ltrcao/granular-display/CADs/C-Bot_base/README

Files are taken from C-Bot design on OpenBuilds at http://openbuilds.com/builds/c-bot.1146/

All .stl files need to be printed out by the amount given in parentheses in their filename.
