ltrcao/granular-display/Arduino Motor Driver PSPICE Schematic/Arduino Motor Driver PSPICE Schematic/asdf2.png

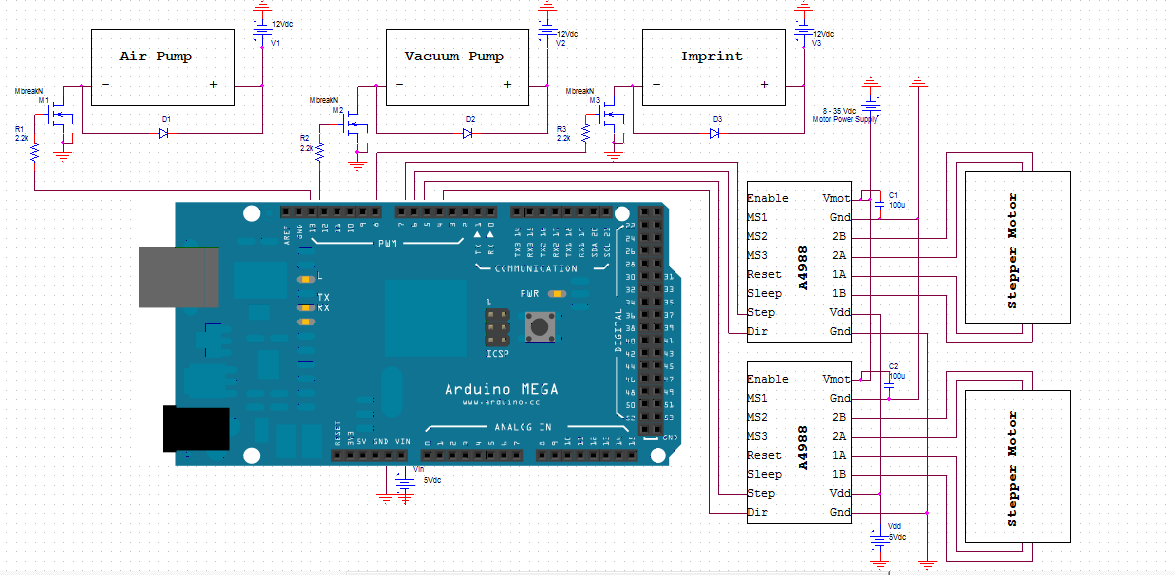
Arduino Motor Driver PSPICE Schematic/Arduino Motor Driver PSPICE Schematic/asdf2.png
