ltrcao/granular-display/Docs/Bill_of_materials.odt

Item (Granular display) | Qty. | Purpose | Reference
Arduino Mega (Atmega2560) | 1 | Microcontroller. 54 I/Os for motor drivers and future expansion. | Link (https://www.sparkfun.com/products/11061)
MOSFETs | 2 | Drivers for pump motor and solenoid valve. Minimum 1A, 12V. | Link (https://www.sparkfun.com/products/10213)
Solenoid valve | 1 | Valve for controlling air tube.
Item (XYZ stage) | Qty. | Purpose | Reference
Stepper drivers | 3 | Drivers for stepper motors on X, Y, Z axes. | Link (https://www.pololu.com/product/1182)
Limit switches | 3 | For homing X, Y, Z axes. | Link (http://www.ebay.com/itm/5-pc-TEMCo-Micro-Limit-Switch-Lever-Arm-Subminiature-SPDT-Snap-Action-LOT-/191202625167)
Stepper motors | 3 | For moving X, Y, Z axes. Use NEMA 17 for ease of design. High torque not necessary.
Timing belts and Pulleys | 2m, 2 | For moving the XY platform. | Link (http://www.ebay.com/itm/2Pcs-GT2-20T-5mm-Bore-6mm-width-Pulley-79-GT2-Timing-Belt-For-3D-Printer-Reprap-/301656602311)
Threaded rod and Coupler | 1, 1 | For moving the pin pressing against the grains. Rod diameter = 8mm is a good starting point.

Additional items:

- Jumper wires, breadboard.
- 5V regulator.
- Diodes, resistors, capacitors.
