ltrcao/granular-display/Docs/BOM_Rework.xls

Sheet: C-Bot BOM
Price Information Accurate Feb. 2016
BOM
Hardware | AMOUNT | Default | COUNT | USD | Alternatives | COUNT | USD | COMMENT
20x40 Extrusion, 1m | 9 | OpenBuilds, Silver (http://openbuildspartstore.com/v-slot-linear-rail/) | 9 | $18.14 | OpenBuilds, Black (http://openbuildspartstore.com/v-slot-linear-rail/) | 9 | $19.96 | Exact amount depends on the heated bed dimension you get
V-Slot Mini V Wheel | 4x5 | OpenBuilds, Derlin (http://openbuildspartstore.com/delrin-mini-v-wheel/) | 20 | $1.25 | OpenBuilds, Extreme (http://openbuildspartstore.com/xtreme-mini-v-wheel/) | 20 | $3.58
V-Wheel Bearings | 40 | Ebay, MR105ZZ (http://www.ebay.com/itm/10pcs-MR105-MR105ZZ-Miniature-Bearings-Ball-Mini-Bearing-5-X-10-X-4mm-/390391020251) | 4 | $3.28 | Ebay, MR105-2RS (http://www.ebay.ca/itm/10pcs-MR105-2RS-Rubber-Sealed-Ball-Bearing-Miniature-Bearing-5-x-10-x-4mm-Blue-/331662658625) | 4 | $4.00 | you can get the rubber seals in cool colors
Precision shim | 20 | OpenBuilds (http://openbuildspartstore.com/mini-v-wheel-precision-shim/) | 20 | $0.28 |  |  |  | Needed between each pair of V-wheel bearings
Short Spacers | 32 | 3D Print (http://www.openbuilds.com/builds/c-bot.1146/) | 0 | $0.00 | Spacer, 6mm (http://openbuildspartstore.com/aluminum-spacers/) | 40 | $0.28
Long Spacers | 8 | 3D Print (http://www.openbuilds.com/builds/c-bot.1146/) | 0 | $0.00 | Spacer, 20mm (http://openbuildspartstore.com/aluminum-spacers/) | 8 | $0.63
 |  |  |  |  | Extra shims to use above two (http://openbuildspartstore.com/mini-v-wheel-precision-shim/) | 40 | $0.28
8mm lead Screw | 30-50cm x2 | Ebay, combo (http://www.ebay.ca/itm/500mm-Length-Lead-Screw-8mm-Screw-Pitch-Brass-Nut-for-Reprap-3D-Printer-Z-Axis-/261941269628) | 2 | $12.00 | MTW, two start (http://store.makerstoolworks.com/motion/two-start-lead-screw-and-nut-single/) | 2 | $24.95 | 4 Start is typical, but 2 start would be better if you can source it in the length needed
5mm/8mm Flex Coupling | 2 | Ebay, Spiral Type (http://www.ebay.ca/itm/5x8-mm-Motor-Jaw-Shaft-Coupler-5mm-To-8mm-Flexible-Coupling-OD-19x25mm-SU-/221594917783) | 2 | $1.10 | Ebay, Jaw Clamp Type (http://www.ebay.ca/itm/400525695992?_trksid=p2060353.m1438.l2649&ssPageName=STRK%3AMEBIDX%3AIT) | 2 | $8.59 | 3D print (http://www.thingiverse.com/thing:366040)
GT2 16 Tooth Pulley | 2 | Ebay (http://www.ebay.ca/itm/2pcs-GT2-Aluminum-Timing-Pulleys-RepRap-Prusa-Mendel-3D-Printer-16-Tooth-Teeth-/141522888429) | 1 | $5.99 | Amazon, combo (http://www.amazon.com/Anycubic-Timing-Pulleys-Meters-Printer/dp/B0152ZNDLK) | 1 | $14.98
GT2 Belt | 2-5m | Ebay (http://www.ebay.ca/itm/5-Meter-197-6mm-Width-GT2-Timing-Belt-For-3D-printer-Rostock-Mendel-REPRAP-/252232179286) | 1 | $6.20
MK8 drive pulley | 1-2 | Ebay (http://www.ebay.ca/itm/Feedstock-Wheel-Extruder-Gear-Hobbed-Gear-Drive-Gear-for-Reprap-3D-printer-good-/121349742050) | 1 | $2.00 | Ebay, alternate (http://www.ebay.com/itm/1-75-3mm-3D-Printer-MK8-Drive-Gear-for-RepRap-Makerbot-Filament-Extruder-Pulley-/252055736275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)
F623ZZ Flange Bearing | 16 | Ebay (http://www.ebay.com/itm/10-x-F623zz-Mini-Metal-Double-Shielded-Flanged-Ball-Bearings-/231540202636) | 2 | $4.99 | Ebay, alternate (http://www.ebay.ca/itm/10pcs-Mini-F623ZZ-3x10x4mm-Double-Shielded-Flange-Ball-Bearing-Flanged-Bearing-/252169403902) | 2 | $5.60
625ZZ Bearing (for extruder) | 1-2 | Ebay (http://www.ebay.ca/itm/2pcs-625ZZ-Miniature-Bearings-ball-Mini-Bearing-5mm-16mm-5mm-/141204979309) | 1 | $1.99 | Ebay, alternate (http://www.ebay.ca/itm/2pcs-625ZZ-Miniature-Bearings-ball-Mini-Bearing-5mm-16mm-5mm-/141204979309) | 1 | $1.98
1/8" Push In Fitting | 2-4 | Ebay (http://www.ebay.ca/itm/5pcs-1-8-Push-In-Fittings-F-bowden-extruder-1-75mm-4mm-OD-PTFE-Tube-3D-Printer-/331723162262) | 1 | $4.00
Bulldog clips | 8 | Ebay (http://www.ebay.ca/itm/10x-Mini-19mm-Metal-Fold-Back-Letter-Notes-Receipt-Money-File-Paper-Binder-Clips-/351587197720) | 1 | $1.50 | Amazon (http://www.amazon.com/Officemate-Silver-Binder-Assorted-31021/dp/B00006IBA2?s=office-products) | 1 | $2.89
Bed Leveling Springs | 4 | Ebay (http://www.ebay.ca/itm/NEW-4pcs-Heated-Bed-Spring-8mm-3D-Printer-DIY-Accessories-/331324945571) | 1 | $4.00 | homedepot (http://www.homedepot.com/p/Everbilt-Spring-Assortment-Kit-84-Pack-15642/202045461) | 1 | $4.37
Extuder Spring | 1-2 | Hobby Shop? | 1 | $1.00 | Ebay, 7mm OD 25mm L (http://www.ebay.ca/itm/0-6mm-Wire-Diameter-5-50mm-L-304-Stainless-Steel-Pressure-Compression-Spring-/281912361412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) | 1 | 9.99 | Mine was from a random spring kit
Heated Bed, various sizes | 1 | Maker Farm (http://www.makerfarm.com/index.php/heat-beds/12-x-12-heat-bed.html) | 1 | $46.50 | Ebay (http://www.ebay.com/itm/RepRap-PCB-Heatbed-200x300mm-Dual-power-12-24V-Perfect-for-Prusa-i3-etc-/281311483823) | 1 | $19.20
Heated Bed Insulation | 1 | Cardboard | 1 | $0.00 | Amazon (http://www.amazon.com/gp/product/B0018DHBAK?psc=1&redirect=true&ref_=oh_aui_detailpage_o01_s00) | 1 | $10.40
Glass to match heated bed | 1 | Household Store/IKEA | 1 | $10.00 | Voxel Factory (https://www.voxelfactory.com/collections/hardware/products/custom-cut-borosilicate-glass) | 1 | $42.37 | Picture frame sales are a good source of cheap glass, boresilicate is best though
Cable/Zip Tie, 4+ | 4-8 | Ebay (http://www.ebay.ca/itm/New-100pcs-Black-8-3x200mm-Locking-Nylon-Plastic-Cable-Wire-Zip-Ties-Cord-Wrap-/291198607167) | 1 | $2.68 |  |  |  | to hold tube and wires to XY carriage
Electrical
Nema 17 Motor | 5-6 | ATinc, Nema 17 (http://www.automationtechnologiesinc.com/products-page/3d-printer/nema17-stepper-motor-kl17h247-150-4a-for-3d-printer) | 5 | $8.99 | Ebay (http://www.ebay.ca/itm/1pcs-3D-Printers-Reprap-68g-cm2-Lead-1-8-Degree-12V-1-2A-Nema17-Stepper-Motor-/291595158449) | 5 | $18.33 | get 68oz*in or better
12V/30A Power Supply | 1 | Amazon (http://www.amazon.com/gp/product/B00D7CWSCG?psc=1&redirect=true&ref_=oh_aui_detailpage_o03_s00) | 1 | $23.97 | Ebay (http://www.ebay.ca/itm/Hot-12V-30A-AC-DC-PSU-Regulated-Switching-Power-Supply-350W-Brand-New-/262242869774) | 1 | $33.95 | Or repurpose an old PC power supply
Print Control Board | 1 | Ramps 1.4 Kit, Ebay (http://www.ebay.ca/itm/3D-Printer-Kit-RAMPS-1-4-Mega2560-A4988-12864-LCD-Controller-for-Arduino-Reprap-/252181241032) | 1 | $31.99 | Azteeg X3 (http://www.panucatt.com/Azteeg_X3_reprap_3d_printer_controller_p/ax33dp.htm) | 1 | $109.99 | Ramps comes bundled in many types of packages
Stepper Drivers | 5 | DRV8825, Ebay (http://www.ebay.ca/itm/Geeetech-Stepper-driver-Pololu-DRV8825-StepStick-for-RAMPS-Sanguinololu-Teensylu-/331167037633) | 5 | $1.59 |  |  |  | DRV8825 can handle more amps and higher temps than A4998s
Endstop for Y and Z | 2 | Ebay (http://www.ebay.com/itm/3x-Mechanical-End-Stop-Endstop-Switch-Module-V1-2-3D-printer-Reprap-Mendel-Pursa-/271443703227) | 1 | $4.49
Endstop connectors | 2 | Ebay (http://www.ebay.com/itm/20PCS-4-pins-white-Connector-leads-Head-XH2-54-2-54mm-connector-kit-DIP-4p-/330928070002) | 2 | $1.62
Endstop for XY carraige | 1 | Ebay (http://www.ebay.ca/itm/Toggle-Collision-Limit-switch-Travel-Switch-for-Robot-Arduino-Brand-New/351214665011) | 1 | $1.77
HotEnd | 1-2 | Filastuder, E3D Lite (http://www.filastruder.com/products/lite6) | 1 | $39.99 | Filastuder, E3Dv6 (http://www.filastruder.com/products/all-metal-e3d-v6-hotend) | 1 | $79.99
Heated Bed Thermister | 1 | Ebay (http://www.ebay.com/itm/100Kohm-NTC-thermistor-temperture-sensor-for-Reprap-hotbed-PCB-MK2a-heated-bed-/231204000452) | 1 | $0.99
Power Switch/ receptacle | 1 | Ebay (http://www.ebay.ca/itm/Panel-IEC320-C14-Inlet-Power-Socket-On-Off-SPST-Red-Rocker-Switch-AC-250V-10A-/321513901251) | 1 | $3.94 | Amazon (http://www.amazon.com/gp/product/B00511QVVK?psc=1&redirect=true&ref_=od_aui_detailpages00) | 1 | $4.44
Relay | 1 | Ebay, Mech (http://www.ebay.ca/itm/30A-High-Current-Contactor-Switch-12V-Electric-Relay-Board-DC-Power-Control-new-/221977262205) | 1 | $4.26 | Amazon, SSR (http://www.amazon.com/Single-Phase-SSR-40DD-DC3-32V-DC5-60V/dp/B012SW6TB6?s=hi) | 1 | $11.71
Cooling Fan, 40mm | 1-3 | Amazon (http://www.amazon.com/gp/product/B00E1JO8SG?psc=1&redirect=true&ref_=oh_aui_detailpage_o00_s00) | 2 | $2.04 | Ebay (http://www.ebay.ca/itm/1pcs-40mm-x-15mm-12V-2Pin-40-40-15MM-Mini-DC-Cooling-Fan-Brushless-Heatsink-/271700616463) | 2 | $2.99 | look at CFM rating
Wire Wrap | 1m | Ebay (http://www.ebay.ca/itm/10-Feet-3-8-Split-Loom-Wire-Flexible-Tubing-Conduit-Polyethylene-Hose-Sales-/261702819864) | 1 | $3.05
4 Core Project Wire | 10m | Ebay (http://www.ebay.ca/itm/2-6-Multicore-Cable-Flexible-Points-Signal-Small-Power-Data-AUTO-Core-CAR-Wire-/261323374911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) | 1 | $13.99
Dupont Connector Cover, 4 pin | 6 | Ebay (http://www.ebay.ca/itm/100pcs-2-54mm-4P-Pitch-Dupont-Jumper-Wire-Cable-Housing-Female-Pin-Connector-/281215490269) | 1 | $1.59
Dupont Connector Cover, 3 pin | 3 | Ebay (http://www.ebay.ca/itm/100pcs-2-54mm-3P-Pitch-Dupont-Jumper-Wire-Cable-Housing-Female-Pin-Connector-/281215488189) | 1 | $1.29
Dupont Connector Cover, 2 pin | 2-3 | Ebay (http://www.ebay.ca/itm/100pcs-2-54mm-2P-Pitch-Dupont-Jumper-Wire-Cable-Housing-Female-Pin-Connector-/281215486233) | 1 | $1.08
Dupont Female Pins | 37 | Ebay (http://www.ebay.ca/itm/500Pcs-Dupont-Jumper-Wire-Cable-Housing-Female-Pin-Connector-Terminal-2-54mm-L-/252045479834) | 1 | $2.55
Fastners
M3 Socket Bolt, 10mm | 50 | mrmetric (http://www.mrmetric.com/metric-fasteners/metric-socket-screw-steel-alloy-12-9/M10045.html) | 50 | $0.10 |  |  |  | for motor mounts, belt clamps, tube holders, endstop attachment
M3 Socket Bolt, 14mm | 2 | mrmetric (http://www.mrmetric.com/metric-fasteners/metric-socket-screw-steel-alloy-12-9/M10047.html) | 2 | $0.11 |  |  |  | for extruder tension arm pivot
M3 Socket Bolt, 20mm | 17-21 | mrmetric (http://www.mrmetric.com/metric-fasteners/metric-socket-screw-steel-alloy-12-9/M10053.html) | 17 | $0.11 |  |  |  | for leadscrew nut blocks, LCD frame, heated bed
M3 Socket Bolt, 25mm | 12 | mrmetric (http://www.mrmetric.com/metric-fasteners/metric-socket-screw-steel-alloy-12-9/M10054.html) | 12 | $0.18 |  |  |  | for belt idlers and hotend clamps
M3 Nut | 30 | mrmetric (http://www.mrmetric.com/metric-fasteners/sc8z-metric-hex-nut/M50013.html) | 30 | $0.02
M3 Nyloc Nut | 17 | mrmetric (http://www.mrmetric.com/metric-fasteners/sc8z-metric-nylock-nuts/M50303.html) | 17 | $0.02
M3 Washer | 80 | mrmetric (http://www.mrmetric.com/metric-fasteners/metric-flat-washer-steel-zinc/M60010.html) | 80 | $0.01 |  |  |  | for bolts and for spacing flanged bearing to make idlers
M5 Socket Bolt, 10mm | 220 | mrmetric (http://www.mrmetric.com/metric-fasteners/metric-socket-screw-steel-alloy-12-9/M10089.html) | 220 | $0.05 |  |  |  | bracket to extrusion connections (lots!)
M5 Socket Bolt, 12mm | 2 | mrmetric (http://www.mrmetric.com/metric-fasteners/metric-socket-screw-steel-alloy-12-9/M10091.html) | 2 | $0.17 |  |  |  | Y endstop bracket
M5 Socket Bolt, 14mm | 2 | mrmetric (http://www.mrmetric.com/metric-fasteners/metric-socket-screw-steel-alloy-12-9/M10093.html) | 2 | $0.16 |  |  |  | Z endstop bracket
M5 Socket Bolt, 40mm | 13 | mrmetric (http://www.mrmetric.com/metric-fasteners/metric-socket-screw-steel-alloy-12-9/M10106.html) | 13 | $0.18 |  |  |  | XY Slides and XY Carriage + Z axis fine adjustment
M5 Socket Bolt, 60mm | 8 | mrmetric (http://www.mrmetric.com/metric-fasteners/metric-socket-screw-steel-alloy-12-9/M10323.html) | 8 | $0.40 |  |  |  | Z Slides
M5 Nyloc Nut | 20 | mrmetric (http://www.mrmetric.com/Discount-Items/Discount-Metric-Nuts/M50306.html) | 20 | $0.07 |  |  |  | V wheel assemblies
M5 Washer | 250 | mrmetric (http://www.mrmetric.com/metric-fasteners/metric-flat-washer-steel-zinc/M60019.html) | 250 | $0.01 |  |  |  | V wheel assemblies, frame construction
M5 Tee Nuts | 225 | OpenBuilds, T-Nuts (http://openbuildspartstore.com/tee-nuts-25-pack/) | 9 | $6.89 | mrmetric, Square Nuts (http://www.mrmetric.com/metric-fasteners/sc4z-metric-square-nuts/M53065.html) | 225 | $0.04 | Don't cheap out and print nuts (my advice from experience)
 |  |  |  | 618.25 | USD
Optional
Dupont Connector Crimp Pliers | 1 | Ebay (http://www.ebay.ca/itm/Pin-Crimping-Tool-Crimper-2-54mm-3-96mm-KF2510-28-18-AWG-Plier-0-1-1-0m-YUCA-/291275778695) | 1 | 12
M3 Thumb Nuts, for bed leveling | 5 | mrmetric (http://www.mrmetric.com/metric-fasteners/sc8z-metric-knurled-nuts/M50759.html) | 5 | $1.32
M5 Thumb Nut, for extruder idler spring | 2 | mrmetric (http://www.mrmetric.com/metric-fasteners/sc8z-metric-knurled-nuts/M50782.html) | 2 | $1.17
Extra Strength Hair Spray | 1 | Local Drug Store | 1 | $8.00
8mm threaded rod for roll holder | 1 | Local Hardware | 1 | $8.00
+ 8mm nut | 2-4 | mrmetric (http://www.mrmetric.com/metric-fasteners/sc10z-metric-hex-nut-m8/) | 2 | $0.12
+ 608ZZ Bearings | 2-4 | Ebay (http://www.ebay.ca/itm/10-x-608ZZ-Deep-Groove-Ball-Bearings-8-22-7mm-for-3D-Printer-8mm-Bore-/261953133583) | 1 | $3.99
M5 Washer 15mm OD | 2 | mrmetric (http://www.mrmetric.com/metric-fasteners/metric-flat-large-od-washer-steel-z/M60355.html) | 2 | $0.03 |  |  |  | Larger Washer for Extruder Spring
M5 Low Profile Bolt, 10mm | 16 | mrmetric (http://www.mrmetric.com/metric-fasteners/metric-button-socket-screws-steel-10-9/M11410.html) | 16 | $0.10 |  |  |  | Optional: for inside of lower frame corner brackets
LEDS | 1 | Amazon (http://www.amazon.com/gp/product/B006LW2NJM?psc=1&redirect=true&ref_=od_aui_detailpages00) | 1 | $8.69 | Ebay (http://www.ebay.ca/itm/10M-600LEDS-3528-SMD-RGB-2X-5M-LED-light-strip-44-Key-IR-Remote-Controller-LU-/161811338109) | 1 | $9.00
Thermal Paste | 1 | Amazon (http://www.amazon.com/gp/product/B00KAOP4SY?psc=1&redirect=true&ref_=oh_aui_detailpage_o02_s00) | 1 | $4.99
 |  |  |  | 56.51 | USD

Sheet: Extrusions Lengths
Heated Bed Dimensions:
If your bed is not square, put the longer side as the length (L)
 | L | W
Enter--> | 320 | 320 | mm
***bed mount hole to mount hole
Lead Screw Length:
 | L
 | 300 | mm
Cut Aluminum lengths to:
Count | Length |  | Purpose
X4 | 480 | mm | <-- front/back, top/bottom horizontal stationary pieces
X1 | 466 | mm | <-- the back/Z moving piece
X1 | 506 | mm | <-- the top/XY moving piece
X2 | 480 | mm | <-- top sides
X2 | 460 | mm | <-- bottom sides
X4 | 450 | mm | <-- legs, gives some flexibility for hotend length and mounting
X2 | 445 | mm | <-- bed support
x1 | 240 | mm | <-- bed front cross piece, only necessary for the front/back leadscrew option
x1 | 520 | mm | <-- offset motor mount option, only necessary for offset Z axis option (AKA D-Bot)
 | 7.462 | m | <--original rear motor mount option
 | 7.702 | m | <--front back leadscrew option
 | 7.982 | m | <--offset leadscrew option
