ltrcao/granular-display/Docs/Extrusion_BOM.xls

Hardware | Amount | Reference | Cost | Purpose | Comment
V-Slot 20x40 Extrusion, 250mm | 5 | OpenBuilds (http://openbuildspartstore.com/v-slot-linear-rail/) | $18.75 | Parts of the frame
V-Slot 20x20 Extrusion, 250mm | 1 | OpenBuilds (http://openbuildspartstore.com/v-slot-linear-rail/) | $3.00 | Part of the frame
V-Slot Mini V-Wheel | 12 | OpenBuilds (http://openbuildspartstore.com/delrin-mini-v-wheel-kit/) | $47.40 | Linear guide for moving along axes | 12 = 4 for y-axis left slider + 4 for y-axis right slider + 4 for x-axis slider
F623ZZ Flange Bearing | 16 |  |  | Guide for timing belt
 |  |  | $69.15
Fasteners
M3 socket bolt, 10mm | 50 | mr. metric (http://www.mrmetric.com/M10045) | $3.50 | For motor mounts, belt clamps, etc. | Amounts listed for fasteners may be more than necessary, but extras are always handy.
M3 socket bolt, 25mm | 12 | mr. metric (http://www.mrmetric.com/M10054) | $2.16 | For belt idlers
M3 nut | 30 | mr. metric (http://www.mrmetric.com/M50013) | $0.60 | Nuts to go with majority of bolts
M3 locknut | 17 | mr. metric (http://www.mrmetric.com/M50303) | $0.34
M3 washer | 80 | mr. metric (http://www.mrmetric.com/M60010) | $2.40 | For use with bolts
M5 socket bolt, 10mm | 220 | mr. metric (http://www.mrmetric.com/M10089) | $17.60 | For connecting brackets to aluminum extrusion
M5 socket bolt, 12mm | 2 | mr. metric (http://www.mrmetric.com/M10091) | $0.34 | For connecting Y-endstop bracket
M5 socket bolt, 40mm | 13 | mr. metric (http://www.mrmetric.com/M10106) | $2.60 | For XY sliders and carriage
M5 locknut | 20 | mr. metric (http://www.mrmetric.com/M50306) | $1.40 | For V-Wheel assembly
M5 washer | 250 | mr. metric (http://www.mrmetric.com/M60019) | $2.50 | For use with bolts
M5 square nut | 225 | mr. metric (http://www.mrmetric.com/M53065) | $9.00 | For connecting brackets to aluminum extrusion
 |  |  | $42.44
 |  |  | $111.59
