ltrcao/granular-display/CADs/C-Bot_base/C-BOT XY Slide Idler (x1).stl

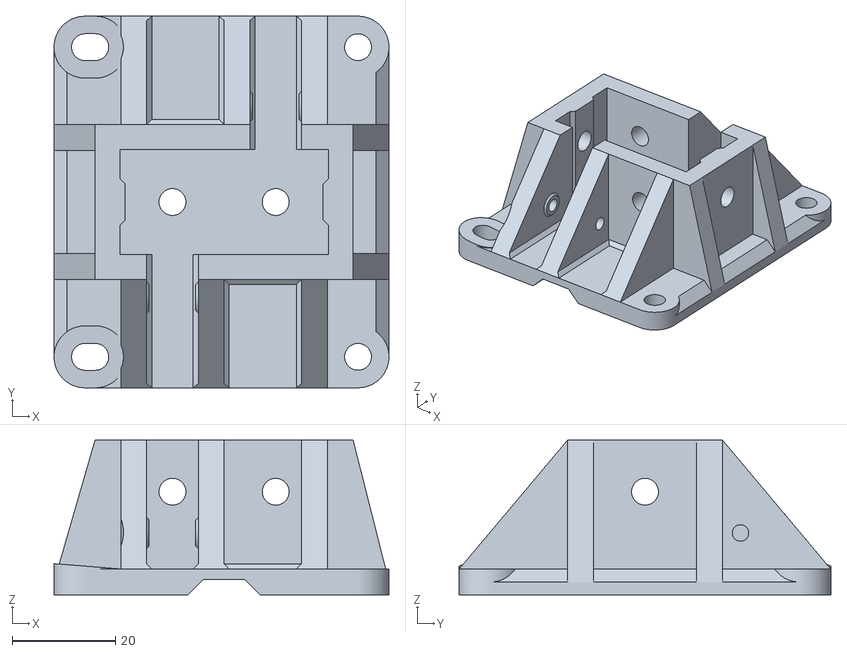
[picture p10: CAD file, 2017-02-10]
CADs/C-Bot_base/C-BOT XY Slide Idler (x1).stl
64.9 x 72.0 x 30.0
