ltrcao/granular-display/CADs/C-Bot_carriage/C-Bot Belt Clamp set of 4.stl

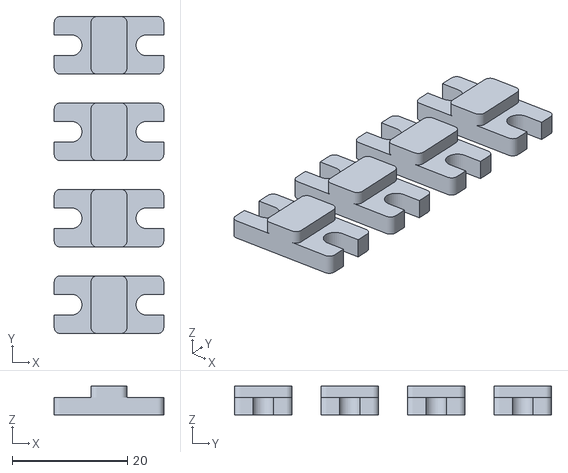
[picture p11: CAD file, 2017-03-13]
CADs/C-Bot_carriage/C-Bot Belt Clamp set of 4.stl
19.0 x 55.0 x 5.00
