ltrcao/granular-display/CADs/C-Bot_carriage/template/C-Bot Bowden Single Front Plate (x1).stl

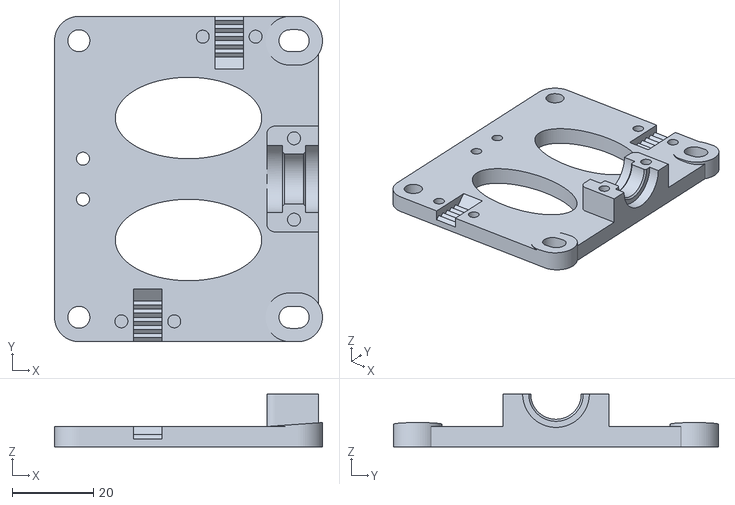
[picture p12: CAD file, 2017-02-10]
CADs/C-Bot_carriage/template/C-Bot Bowden Single Front Plate (x1).stl
65.9 x 80.0 x 13.0
