ltrcao/granular-display/CADs/workarounds/v-slot_filler_19h.stl

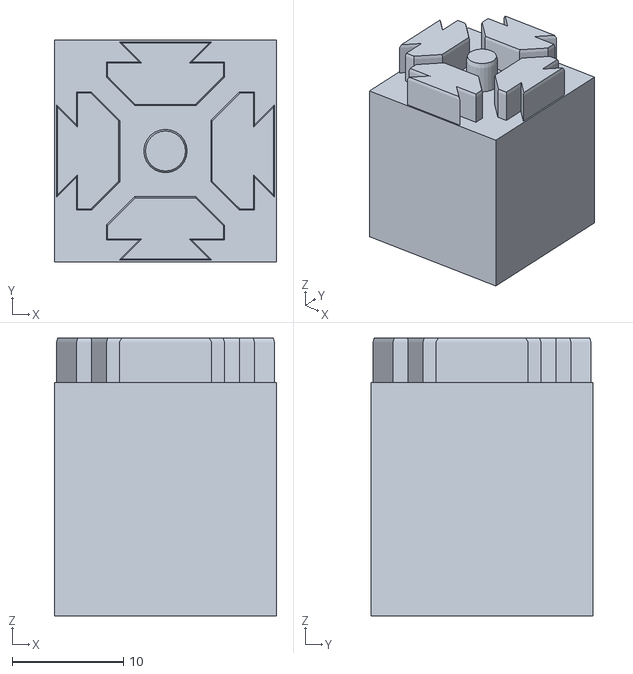
[picture p13: CAD file, 2017-03-13]
CADs/workarounds/v-slot_filler_19h.stl
20.0 x 20.0 x 25.0
