ltrcao/granular-display/CADs/C-Bot_carriage/C-Bot Belt Clamp (x4).stl

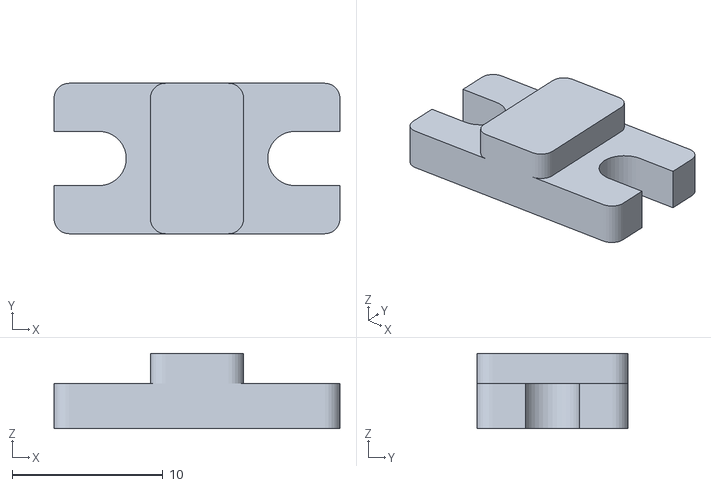
[picture p14: CAD file, 2017-02-10]
CADs/C-Bot_carriage/C-Bot Belt Clamp (x4).stl
19.0 x 10.0 x 5.00
