ltrcao/granular-display/CADs/C-Bot_carriage/template/C-Bot Bowden Carriage Rear Plate (x1).stl

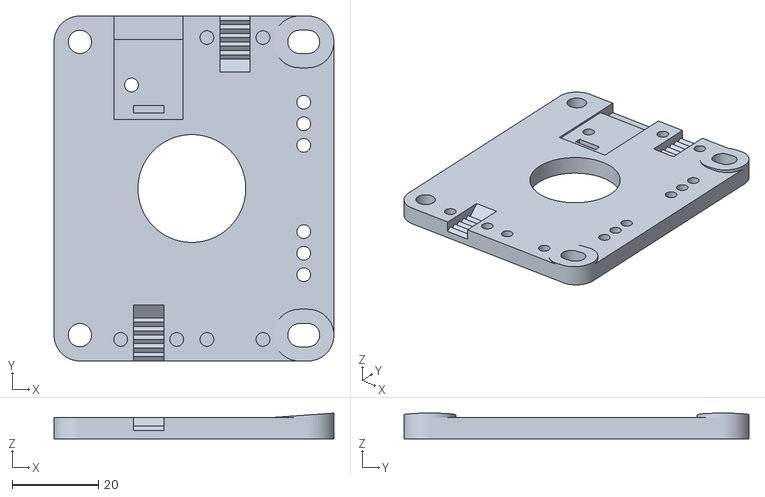
[picture p15: CAD file, 2017-02-10]
CADs/C-Bot_carriage/template/C-Bot Bowden Carriage Rear Plate (x1).stl
64.9 x 80.0 x 6.00
