ltrcao/granular-display/CADs/workarounds/v-slot_filler_39h.stl

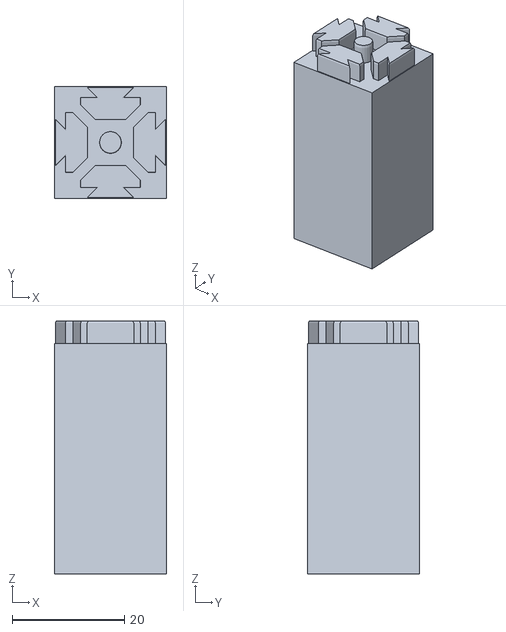
[picture p16: CAD file, 2017-03-13]
CADs/workarounds/v-slot_filler_39h.stl
20.0 x 20.0 x 45.0
