ltrcao/granular-display/CADs/C-Bot_base/C-BOT V-Wheel Spacer (x16).stl

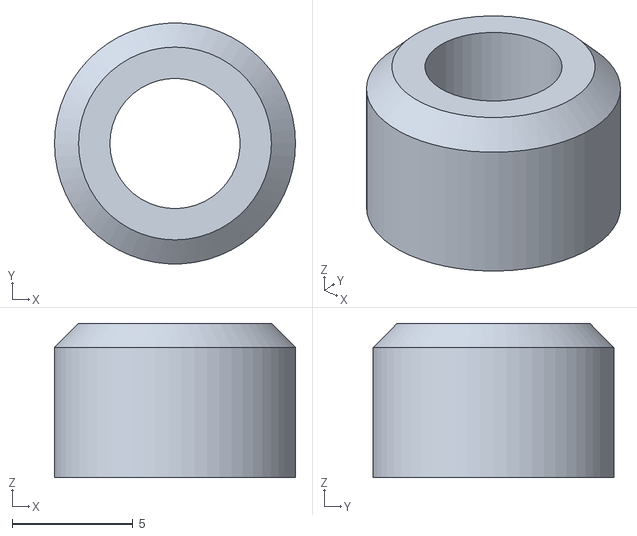
[picture p17: CAD file, 2017-02-10]
CADs/C-Bot_base/C-BOT V-Wheel Spacer (x16).stl
10.0 x 9.99 x 6.40
