ltrcao/granular-display/CADs/workarounds/v-slot_filler_20h.stl

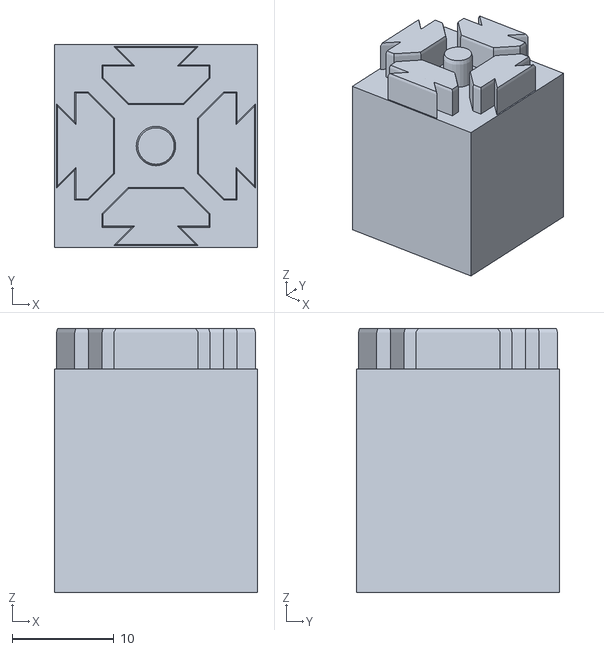
[picture p18: CAD file, 2017-03-13]
CADs/workarounds/v-slot_filler_20h.stl
20.0 x 20.0 x 26.0
