ltrcao/granular-display/CADs/C-Bot_base/C-BOT XY Rear Idler (x1).stl

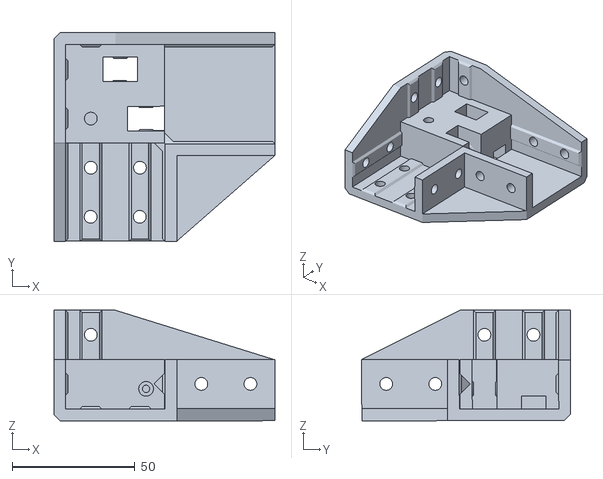
[picture p19: CAD file, 2017-02-10]
CADs/C-Bot_base/C-BOT XY Rear Idler (x1).stl
90.0 x 85.0 x 45.0
