ltrcao/granular-display/CADs/workarounds/v-slot_endcap_2020_fixed.stl

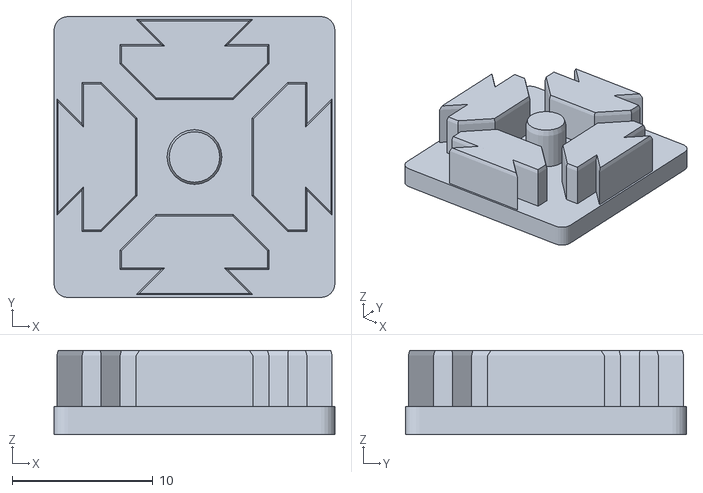
[picture p20: CAD file, 2017-02-09]
CADs/workarounds/v-slot_endcap_2020_fixed.stl
20.0 x 20.0 x 6.00
