ltrcao/granular-display/CADs/workarounds/v-slot_endcap_2020.stl

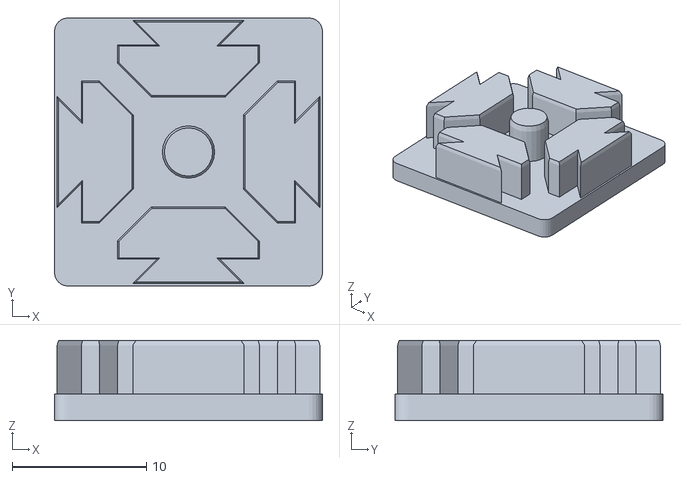
[picture p21: CAD file, 2017-02-09]
CADs/workarounds/v-slot_endcap_2020.stl
20.0 x 20.0 x 6.00
