ltrcao/granular-display/CADs/C-Bot_base/C-BOT XY Motor Mount Right (x1).stl

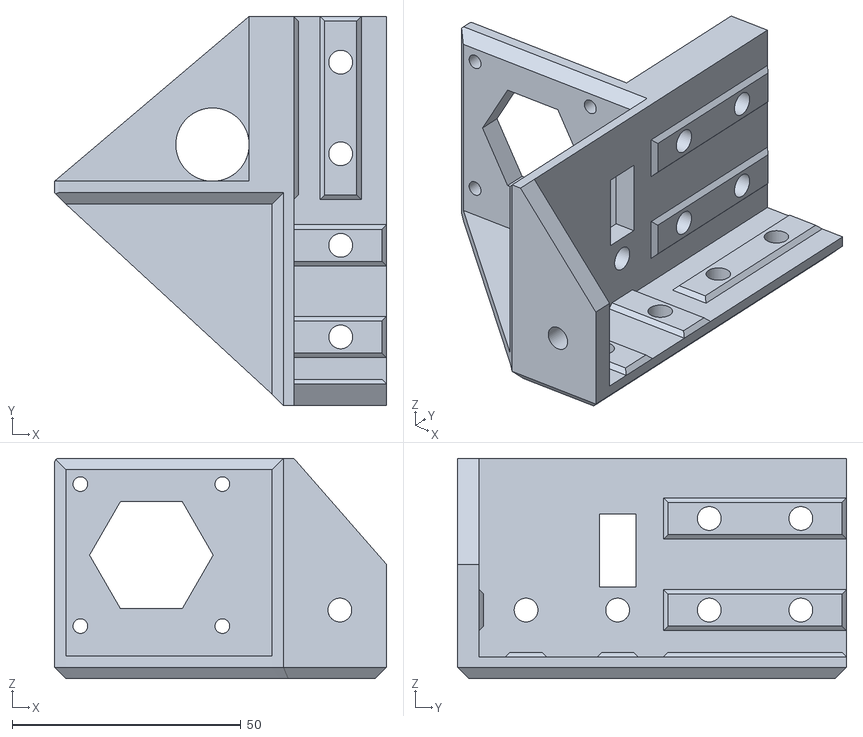
[picture p22: CAD file, 2017-02-10]
CADs/C-Bot_base/C-BOT XY Motor Mount Right (x1).stl
72.5 x 85.0 x 48.2
