ltrcao/granular-display/CADs/C-Bot_base/C-BOT XY Slide Rear Plate (x2).stl

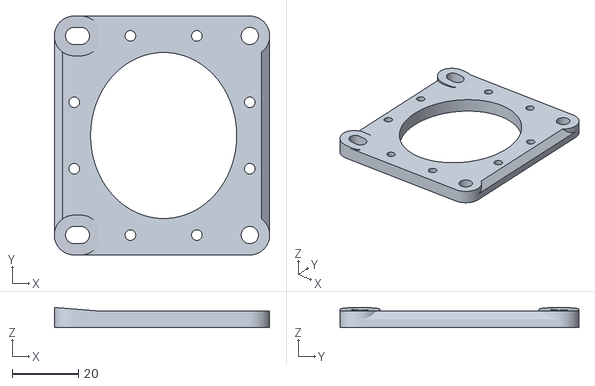
[picture p23: CAD file, 2017-02-10]
CADs/C-Bot_base/C-BOT XY Slide Rear Plate (x2).stl
64.9 x 72.0 x 6.06
