ltrcao/granular-display/CADs/scrapped_designs/XY_Stage/config.scad

// ===========================================================================
// Configuration file for the whole XY-stage design.
// ===========================================================================

// Parameters for stepper bracket
BRACKET_EDGE_LENGTH = 42.3;
BRACKET_DIAMETER = 22;
BRACKET_THICKNESS = 4;
SCREW_DIAMETER = 3;
SCREW_DISTANCE = 31;
SHAFT_HEIGHT = 24;
// ------------------------------

// Parameters for anchor
ANCHOR_THICKNESS = 4;
ANCHOR_SHAFT_OVERHEAD = 4;
ANCHOR_WIDTH = 40;
ANCHOR_SCREW_MARGIN = 7;
ANCHOR_SCREW_DIAMETER = 3;
// ---------------------

// Parameters for pulleys
PULLEY_INNER_DIAMETER = 8;
PULLEY_OUTER_DIAMETER = 25;
PULLEY_WIDTH = 9;
PULLEY_MARGIN = 3;
PULLEY_BACK_THICKNESS = 5;
PULLEY_DISTANCE = 3;
// ---------------------

PULLEY_CENTER = (PULLEY_MARGIN + PULLEY_OUTER_DIAMETER) / 2;
PULLEY_HEIGHT = 2 * PULLEY_WIDTH + 2 * ANCHOR_THICKNESS + PULLEY_DISTANCE;
PULLEY_EDGE_LENGTH = PULLEY_OUTER_DIAMETER + PULLEY_MARGIN;

// Parameters for stage brackets
ROD_BRACKET_DIAMETER = 8;
ROD_BRACKET_DEPTH = 5;
ROD_BRACKET_THICKNESS = 4;
// -----------------------------

ROD_BRACKET_WIDTH = (PULLEY_OUTER_DIAMETER - PULLEY_INNER_DIAMETER) / 2;
ROD_BRACKET_LENGTH = ROD_BRACKET_DIAMETER + ROD_BRACKET_THICKNESS;

// Parameters for the platform
PLATFORM_LENGTH = 40;
PLATFORM_WIDTH = 60;
LINEAR_BEARING_OUTER_DIAMETER = 15;
LINEAR_BEARING_BRACKET_THICKNESS = 2;
TIMING_BELT_PITCH = 2;
TIMING_BELT_CREST = 1.5; // default: 1.38
TIMING_BELT_TROUGH = 0.75; // default: 0.75
TIMING_BELT_TRAP_THICKNESS = 4;
// ---------------------------

TIMING_BELT_TRAP_WIDTH = 5.5 * TIMING_BELT_PITCH;
LINEAR_BEARING_BRACKET_WIDTH = LINEAR_BEARING_BRACKET_THICKNESS * 2 + LINEAR_BEARING_OUTER_DIAMETER;


// Parameters for XY-stage
STEPPER_MOTOR_PULLEY_DIAMETER = 20;
STEPPER_MOTOR_PULLEY_HEIGHT = 12;
// ----------------------
