ltrcao/granular-display/CADs/supportive_grid.scad

//%translate([0,0,-8.8]) import("supportive_grid_parab.stl");

// The design is parametric, so only the constants below need to be changed.
//// Dimension configuration ////
//$fn = 40; // Set $fn to 40 before exporting to .stl to round the pinheads.
NUM_GRID_X = 16;
NUM_GRID_Y = 16;
GRID_LENGTH_X = 10;
GRID_LENGTH_Y = 10;
THREAD_WIDTH_X = 2;
THREAD_WIDTH_Y = 2;
THREAD_THICKNESS_X = 2.5;
THREAD_THICKNESS_Y = 2.5;
WALL_THICKNESS = 10;
WALL_HEIGHT = 5;

PIN_THICKNESS = 4;
PIN_LENGTH = 8;
PIN_CONNECTION_THICKNESS = 0.5;
PIN_CONNECTION_WIDTH = 1.5;
PIN_PARALLEL_TO_X = true; // Set the parabola direction
////////////////////////////////

//difference(){
//translate([-12,-12,-13]) cube([106,106,18]);
//translate([-8,-8,-15]) cube([98,98,22]);
//
//    translate([0,0,0.4]) supportive_grid();
//}
//// Render toggle ////
RENDER_SUPPORTIVE_GRID = true;
RENDER_PIN_GRID = true;
///////////////////////


// Map for rendering mock imprints
MAP_WHAT_IF = [[ 0, 0, 0, 0, 0, 0, 0, 0, 0, 0, 0, 0, 0, 0, 0, 0],
               [ 0, 1, 0, 0, 0, 0, 0, 0, 0, 0, 0, 0, 0, 0, 0, 0],
               [ 0, 1, 1, 0, 0, 0, 0, 0, 0, 0, 0, 0, 0, 0, 0, 0],
               [ 0, 1, 1, 0, 0, 0, 0, 0, 0, 0, 0, 0, 0, 0, 0, 0],
               [ 1, 1, 1, 1, 0, 0, 0, 0, 0, 0, 0, 0, 0, 0, 0, 0],
               [ 1, 1, 1, 1, 0, 0, 0, 0, 0, 0, 0, 0, 0, 0, 0, 0],
               [ 1, 1, 1, 1, 1, 1, 1, 1, 1, 0, 0, 0, 0, 0, 0, 0],
               [ 0, 1, 1, 1, 1, 1, 1, 1, 1, 1, 0, 0, 0, 0, 0, 0],
               [ 0, 1, 1, 1, 1, 1, 1, 1, 1, 1, 0, 0, 0, 0, 0, 0],
               [ 0, 1, 1, 1, 1, 1, 1, 1, 1, 1, 1, 0, 0, 0, 0, 0],
               [ 0, 1, 1, 1, 1, 1, 1, 1, 1, 1, 1, 0, 0, 0, 0, 0],
               [ 0, 1, 1, 1, 1, 1, 1, 1, 1, 1, 1, 0, 0, 0, 0, 0],
               [ 0, 0, 1, 1, 1, 1, 1, 1, 1, 1, 1, 0, 0, 0, 0, 0],
               [ 0, 0, 1, 1, 1, 1, 1, 1, 1, 1, 1, 0, 0, 0, 0, 0],
               [ 0, 0, 0, 1, 1, 1, 1, 1, 1, 1, 1, 0, 0, 0, 0, 1],
               [ 0, 0, 0, 0, 1, 1, 1, 1, 1, 1, 1, 1, 1, 1, 1, 0]
               ];

// Master switch for rendering mock imprints
RENDER_WHAT_IF = false;


// Parabolic function for push pins
function pin_fn(x) = 8 / GRID_LENGTH_X * x * x;


if (RENDER_SUPPORTIVE_GRID) {
    supportive_grid();
}

if (RENDER_PIN_GRID) {
    pin_grid();
}

// Create the supportive grid/frame to hold granular material.
module supportive_grid() {
    // create grids
    for (offsetX = [0 : GRID_LENGTH_X : GRID_LENGTH_X * NUM_GRID_X])
        translate([offsetX, 0, 0])
            cube([THREAD_WIDTH_X, GRID_LENGTH_Y * NUM_GRID_Y + THREAD_WIDTH_Y, THREAD_THICKNESS_X]);

    for (offsetY = [0 : GRID_LENGTH_Y : GRID_LENGTH_Y * NUM_GRID_Y])
        translate([0, offsetY, 0])
            cube([GRID_LENGTH_X * NUM_GRID_X + THREAD_WIDTH_X, THREAD_WIDTH_Y, THREAD_THICKNESS_Y]);
    // done creating grids


    // create walls
    union() {
        for (offsetX = [-WALL_THICKNESS, THREAD_WIDTH_Y + GRID_LENGTH_X * NUM_GRID_X])
            translate([offsetX, -WALL_THICKNESS, 0])
                cube([WALL_THICKNESS, GRID_LENGTH_Y * NUM_GRID_Y + THREAD_WIDTH_Y + 2 * WALL_THICKNESS, WALL_HEIGHT]);

        for (offsetY = [-WALL_THICKNESS, THREAD_WIDTH_X + GRID_LENGTH_Y * NUM_GRID_Y])
            translate([-WALL_THICKNESS, offsetY, 0])
                cube([GRID_LENGTH_X * NUM_GRID_X + THREAD_WIDTH_X + 2 * WALL_THICKNESS, WALL_THICKNESS, WALL_HEIGHT]);
    }
    // done creating walls
}

// Create push pins with connection lines
module pin_grid() {
    for (offsetX = [0 : GRID_LENGTH_X : GRID_LENGTH_X * NUM_GRID_X - 0.001]) {
        for (offsetY = [0 : GRID_LENGTH_Y : GRID_LENGTH_Y * NUM_GRID_Y - 0.001]) {
            translate([offsetX + THREAD_WIDTH_X / 2, offsetY + THREAD_WIDTH_Y / 2, 0]) {
                union() {
                    translate([GRID_LENGTH_X / 2, GRID_LENGTH_Y / 2, 0]) {
                        rotate([0, 0, PIN_PARALLEL_TO_X ? 0 : 90]) {
                            translate([0, -PIN_THICKNESS / 2, (RENDER_WHAT_IF && MAP_WHAT_IF[offsetX / GRID_LENGTH_X][offsetY / GRID_LENGTH_Y] != 0) ? 10 : 0]) {
                                rotate([-90, 0, 0]) {
                                    color((RENDER_WHAT_IF && MAP_WHAT_IF[offsetX / GRID_LENGTH_X][offsetY / GRID_LENGTH_Y] != 0) ? "orange" : "cyan")
                                    linear_extrude(height=PIN_THICKNESS) {
                                        polygon([for (x = [-PIN_LENGTH / 2 : PIN_LENGTH/ 16 : PIN_LENGTH / 2]) [x, pin_fn(x)]]);
                                    }
                                }
                            }
                        }
                    }

                    // Connection lines
                    translate([GRID_LENGTH_X / 2 - PIN_CONNECTION_WIDTH / 2, 0, -pin_fn(PIN_LENGTH / 2)])
                        translate([0,-13,0]) cube([PIN_CONNECTION_WIDTH, GRID_LENGTH_X+26, PIN_CONNECTION_THICKNESS]);
                    translate([0, GRID_LENGTH_Y / 2 - PIN_CONNECTION_WIDTH / 2, -pin_fn(PIN_LENGTH / 2)])
                        translate([-13,0,0]) cube([GRID_LENGTH_Y+26, PIN_CONNECTION_WIDTH, PIN_CONNECTION_THICKNESS]);
                }
            }
        }
    }
}
