ltrcao/granular-display/CADs/C-Bot_carriage/spacers.scad

import("C-Bot Belt Clamp (x4).stl");
translate([0,-15,0]) import("C-Bot Belt Clamp (x4).stl");
translate([0,-30,0]) import("C-Bot Belt Clamp (x4).stl");
translate([0,-45,0]) import("C-Bot Belt Clamp (x4).stl");
