ltrcao/granular-display/(list of files, cad)

Other CAD files:
CADs/C-Bot_base/C-BOT XY Slide Idler w Endstop Contact (x1).stl
CADs/C-Bot_carriage/C-Bot V-Wheel Spacer (x8).stl
CADs/C-Bot_base/C-BOT XY Rear Idler F (x1).stl
CADs/C-Bot_base/C-BOT XY Motor Mount Left (x1).stl
CADs/scrapped_designs/XY_Stage/platform_stub.scad
