ltrcao/granular-display/(list of files, drawings)

Other design files:
Arduino Motor Driver PSPICE Schematic/Arduino Motor Driver PSPICE Schematic/ARDUINO MOTOR DRIVER.DSN
Arduino Motor Driver PSPICE Schematic/Arduino Motor Driver PSPICE Schematic/Arduino Motor Driver.opj
