ltrcao/granular-display/(commit log)

2016-10-08 Initial commit.
    [braille_dot_mechanism_1.scad, braille_dot_mechanism_2.scad, granular_frame.scad, servo_coupler.scad]
2016-10-09 Converted granular frame SCAD file to Unix format.
    [granular_frame.scad]
2016-10-09 Removed irrelevant SCAD files. Added render configuration to granular frame SCAD.
    [braille_dot_mechanism_1.scad, braille_dot_mechanism_2.scad, granular_frame.scad, servo_coupler.scad]
2016-10-10 Updated radii of the holes/pins.
    [granular_frame.scad]
2016-10-10 Made pin connections part of the pins themselves.
    [granular_frame.scad]
2016-10-10 Reduced pin guide thicknesses to lower filament cost.
    [granular_frame.scad]
2016-10-10 Implemented pin locking.
    [granular_frame.scad]
2016-10-10 Corrected locking size
    [granular_frame.scad]
2016-10-10 Reverted locking size.
    [granular_frame.scad]
2016-10-11 Use the frame itself as pin guide.
    [granular_frame.scad]
2016-10-12 Added SCAD file for supportive grid.
    [supportive_grid.scad]
2016-10-20 Added surrounding walls.
    [supportive_grid.scad]
2016-11-10 Added some documents and images we have so far.
    [supportive_grid.scad]
2016-11-16 Finalized supportive grid.
    [supportive_grid.scad, supportive_grid.stl]
2016-11-16 Modeled brackets for stepper motors.
    [stepper_bracket.scad, xy_stage.scad]
2016-11-16 Modeled double pulleys for CoreXY design.
    [config.scad, double_pulley.scad, stepper_bracket.scad, xy_stage.scad]
2016-11-16 Added horizontal stage brackets.
    [config.scad, stage_bracket.scad, xy_stage.scad]
2016-11-17 Added platform and finished mockup of XY stage.
    [config.scad, platform.scad, xy_stage.scad, xy_stage.stl]
2016-11-18 Created STL files for XY stage components.
    [double_pulley.stl, platform.stl, stage_bracket.stl, stepper_bracket.stl, supportive_grid.scad, supportive_grid.stl]
2016-12-01 Redesigned timing belt trap to have a thicker back support structure.
    [config.scad, platform.scad, platform.stl, platform_stub.scad, platform_stub.stl]
2017-01-18 Added new Bill of Materials for aluminum extrusion-based frame.
    [C-Bot_BOM_adapted.xls, Extrusion_BOM.xls]
2017-02-01 Removed precompiled .stls
    [double_pulley.stl, platform.stl, platform_stub.stl, stage_bracket.stl, stepper_bracket.stl, supportive_grid.stl, xy_stage.stl]
2017-02-02 Added missing F623ZZ into BOM. No good USA reference outside of eBay and Amazon found.
    [BOM_Rework.xls, Extrusion_BOM.xls]
2017-02-02 Added pin grid to supportive_grid.
    [config.scad, double_pulley.scad, granular_frame.scad, platform.scad, platform_stub.scad, stage_bracket.scad, stepper_bracket.scad, supportive_grid.scad]
2017-02-02 Rounded the pinheads to avoid punctures.:wq
    [supportive_grid.scad]
2017-02-08 Changed pin shape to parabola.
    [supportive_grid.scad]
2017-02-09 Added currently unrenderable v-slot filler.
    [v-slot_endcap_2020.stl, v-slot_filler.scad]
2017-02-09 added repaired stl
    [v-slot_endcap_2020_fixed.stl]
2017-02-09 updated to use new stl
    [v-slot_filler.scad]
2017-02-09 Removed unused variable.
    [supportive_grid.scad]
2017-02-10 Saved C-Bot .stl files on which our XY stage in based. Started designing carriage to hold the imprint actuator.
    [C-BOT V-Wheel Spacer (x16).stl, C-BOT XY Motor Mount Left (x1).stl, C-BOT XY Motor Mount Right (x1).stl, C-BOT XY Rear Idler (x1).stl, C-BOT XY Rear Idler F (x1).stl, C-BOT XY Slide Idler (x1).stl, C-BOT XY Slide Idler w Endstop Contact (x1).stl, C-BOT XY Slide Rear Plate (x2).stl]
2017-02-16 Designed top platform piece for XY carriage.
    [carriage.scad]
2017-02-16 Updated Schematic
    Motor drivers were connected to digital pins on arduino mega, not PWM pins. Updated the schematic with changes to the connection to the motor drivers
2017-02-19 Started work on servo arm mount for trackball.
    [servo_arm.scad, servo_arm_mount.stl]
2017-02-22 Added mounting screw holes to servo arm mount piece.
    [servo_arm.scad]
2017-02-23 Started work on mount for granular display
    [display_mount.scad]
2017-02-23 Designed display mount piece for rear idler units.
    [display_mount.scad]
2017-02-23 Completed design of mount pieces for holding granular display on top of XY stage.
    [display_mount.scad]
2017-02-24 Completed design of carriage's top piece.
    [carriage.scad, display_mount.scad, servo_bracket.stl]
2017-02-24 Updated display mount dimensions
    [display_mount.scad]
2017-02-25 Updated servo arm mount with new dimensions.
    [servo_arm.scad]
2017-02-27 Added a gap for servo arm mounts.
    [servo_arm.scad]
2017-03-04 changes to coordinates of the servo arm
    [servo_arm.scad]
2017-03-06 New schematic
    [ARDUINO MOTOR DRIVER.DSN, Arduino Motor Driver.opj]
2017-03-13 added frame and updated lift pins
    [supportive_grid.scad]
2017-03-13 added frame and adjusted parabolas
    [C-Bot Belt Clamp set of 4.stl, servo_arm_mount.stl, servo_bracket.stl, spacers.scad, v-slot_filler_19h.stl, v-slot_filler_20h.stl, v-slot_filler_39h.stl]
2017-03-15 added spring loaded code
    [carriage.scad]
2017-04-07 Implemented support for rendering mock imprints.
    [supportive_grid.scad]
2017-04-07 Refactored spring-loaded carriage design to be more parametric.
    [carriage.scad]
2017-04-07 Updated carriage assembly preview.
    [carriage.scad]
